TheoFizzarotti/Gardien-de-babyfoot-automatique/Rapports séance/Théo FIZZAROTTI/Projet Séance 3.pdf

Début du programme du moteur. Comme c’est un moteur pas à pas, lorsque nous voulons qu’il fasse une rotation, nous devons calculer le nombre de pas qu’il doit faire pour que la rotation soit effectuée. Le pas est de 1,8°. Le diamètre du pignon est de 4,5 cm. Donc la course de la crémaillère pour un tour complet de pignon est de 0,045π m/tour.
Soit pour un pas, 0,225π mm/pas soit environ 0,707 mm/pas. Maintenant j’ai besoin de savoir dans chaque tour de boucle du programme, la distance que je dois faire, pour cela je dois réceptionner cette information de la pixycam et c’est Théo qui s’en charge, je dois donc avoir cette information pour continuer.

Programme actuel :

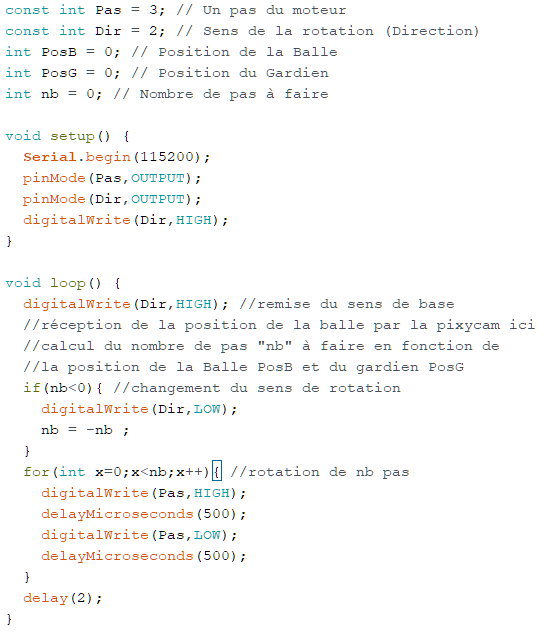
[picture p9: figure]

Pour recevoir cette information, nous devons utiliser des modules Bluetooth, j’ai donc de mon côté fais le branchement du module esclave :

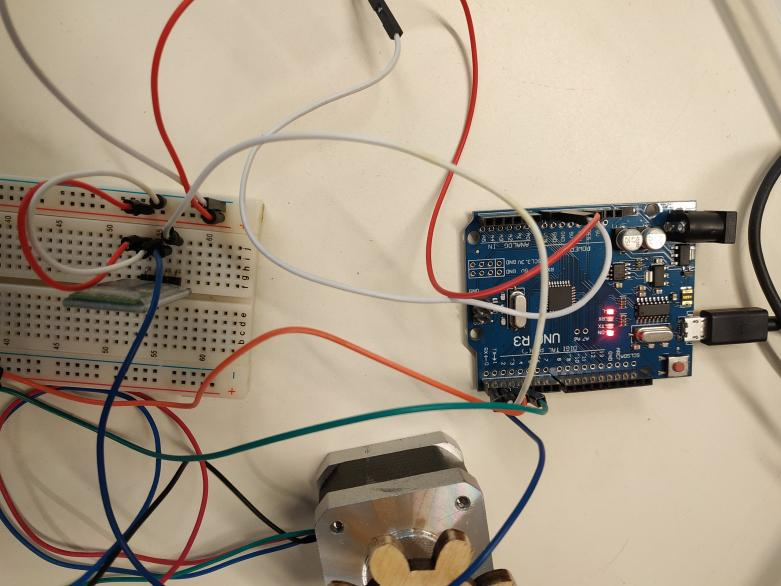
[picture p10: figure]

Théo a lui, de son côté, fait le branchement du module maître, nous avons ensuite récupéré les programmes Arduino du cours sur le Bluetooth de M.Masson, mais nous n’avons pas réussi pour le moment à établir la communication entre les 2 modules Bluetooth.
Objectif de la prochaine séance : Réussir à établir la communication entre les 2 modules Bluetooth afin de réceptionner l’information de position de la balle de la pixycam.
