TheoFizzarotti/Gardien-de-babyfoot-automatique/Rapports séance/NOCENTINI Théo/Rapport 3.pdf

Séance 3

Maintenant que la coordonnée de la balle est récupéré par la Pixycam,, et stockée dans une variable du code de l’arduino. Il faut envoyer cette variable à une seconde Arduino.
Pour cela je me suis renseigné sur des modules bluetooth et j*********** **** l’exemple de la vidéo suivante: https://www.youtube.com/watch?v=hyME1osgr7s
pour vérifier le fonctionnement du bluetooth.
J’ai donc fait le branchement “Maitre”

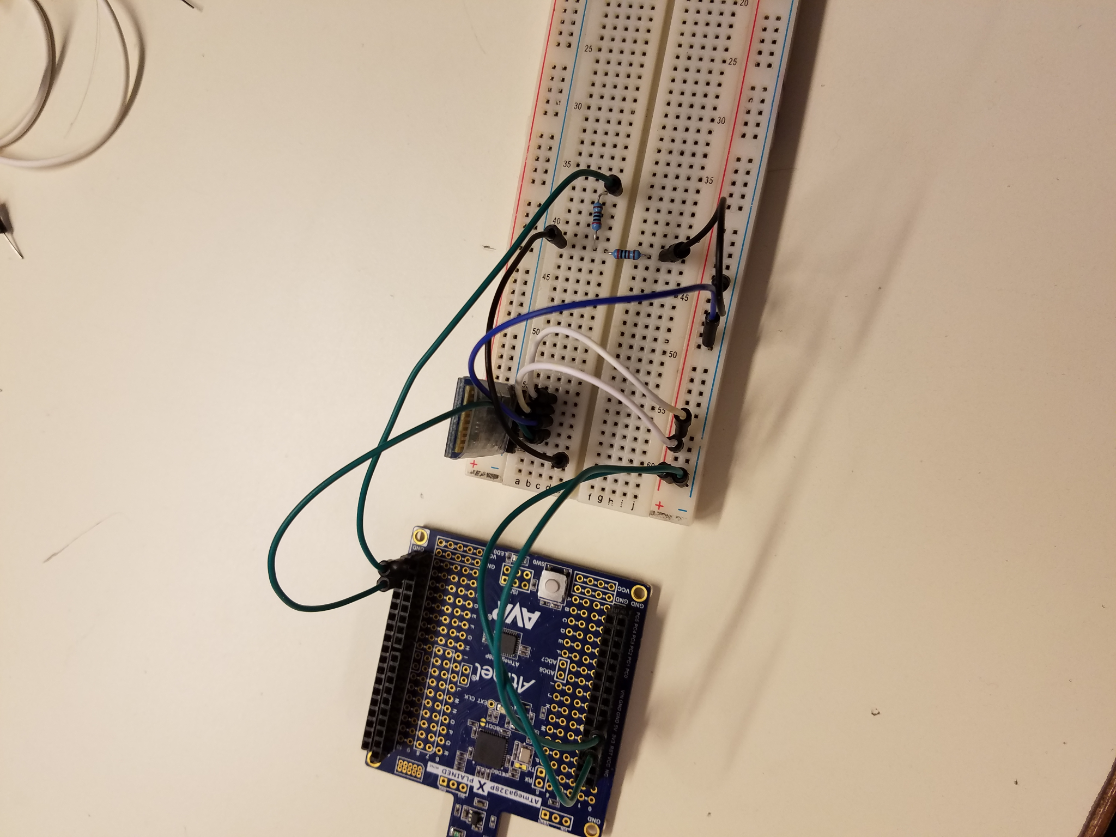
[picture p11: figure]

Ensuite, il fallait donc que j’utilise l’autre carte Arduino pour faire le montage “esclave”, et que l’on réfléchisse pour transformer la coordonnée en mouvement sur le moteur, il a donc fallu mettre nos travaux en commun.

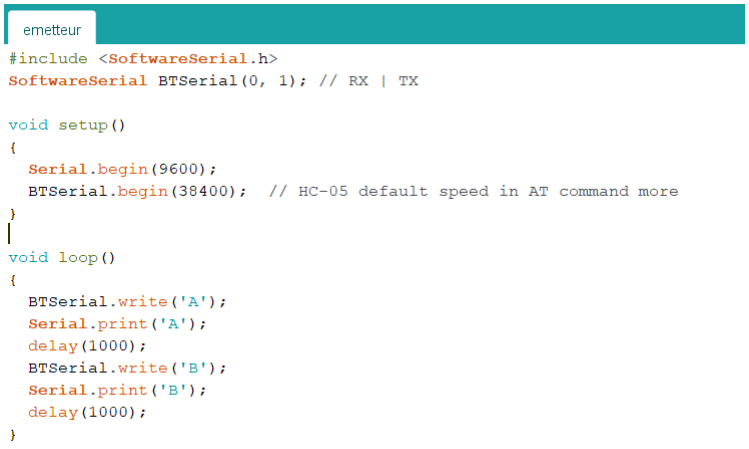
[picture p12: figure]

Voila donc le code “Maitre”, une fois qu’on aura verifié qu’il est fonctionnel il suffira de write les coordonnées que nous avons récupéré dans la séance précédente.

Le code “slave” va recevoir cette valeur et va la transformer en nombre de pas du moteur.

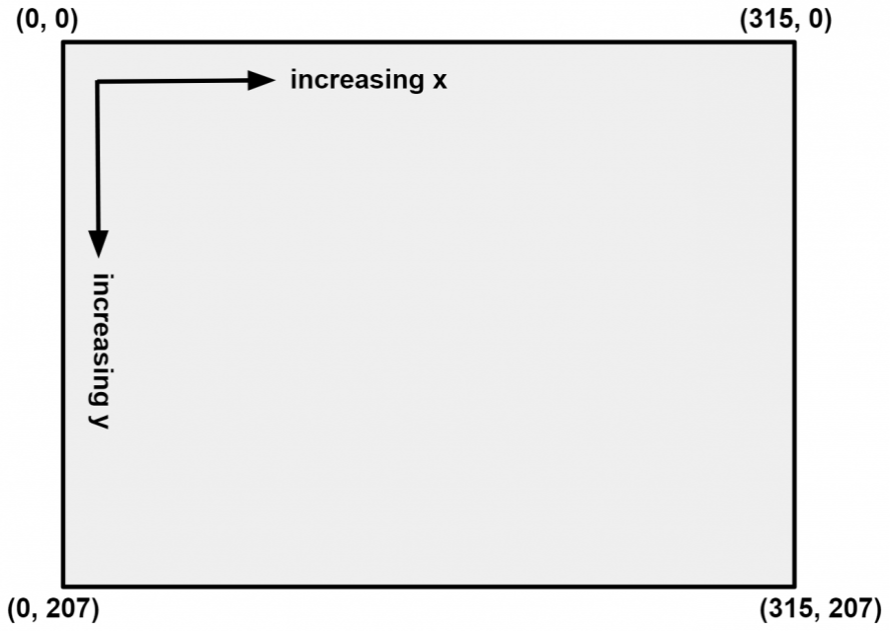
[picture p13: figure]

Voici la vision de la Pixycam, selon la ou on la place nous devrons simplement regarder la coordonnée x ou y.

Il faudra placer la caméra en hauteur tel que la caméra voit environ 72cm en largeur.
Ensuite nous pourrons calculer la distance a laquelle corresponds 1 unité de x. Puis on pourra transformer cette valeur en nombre de pas sur le moteur.
