TheoFizzarotti/Gardien-de-babyfoot-automatique/Rapports séance/Théo FIZZAROTTI/Projet Séance 7.pdf

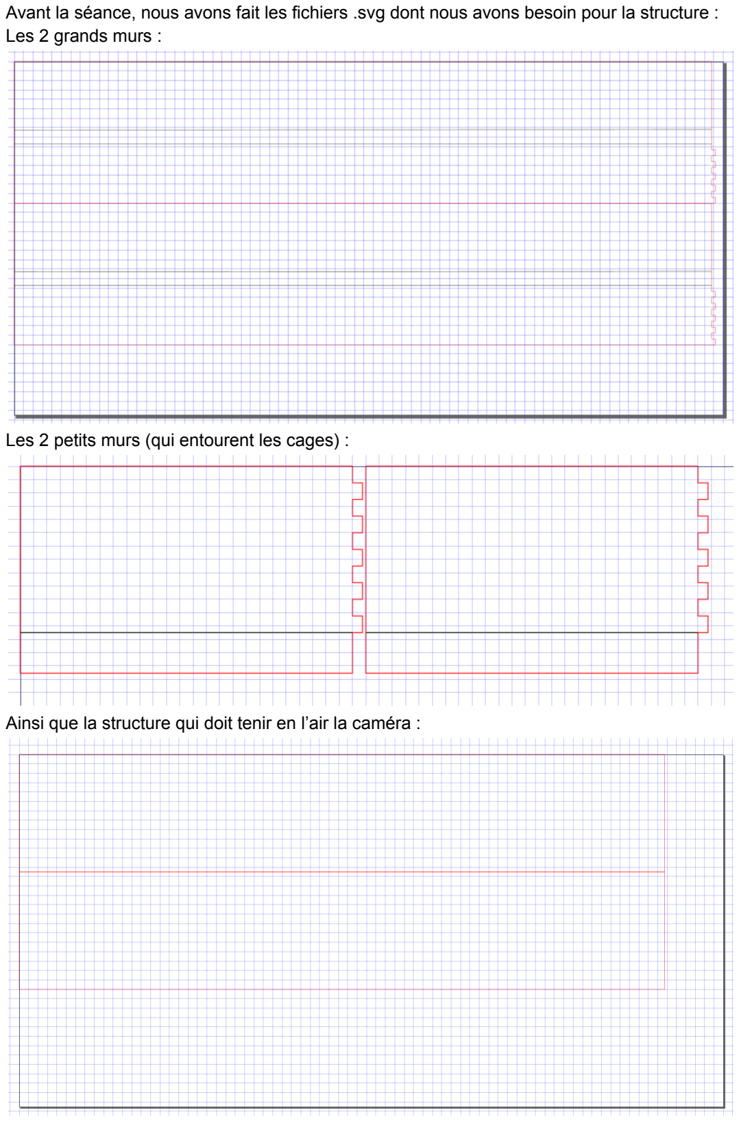
[picture p25: page 1]

Avant la séance, nous avons fait les fichiers .svg dont nous avons besoin pour la structure : Les 2 grands murs :

Les 2 petits murs (qui entourent les cages) :

Ainsi que la structure qui doit tenir en l’air la caméra :

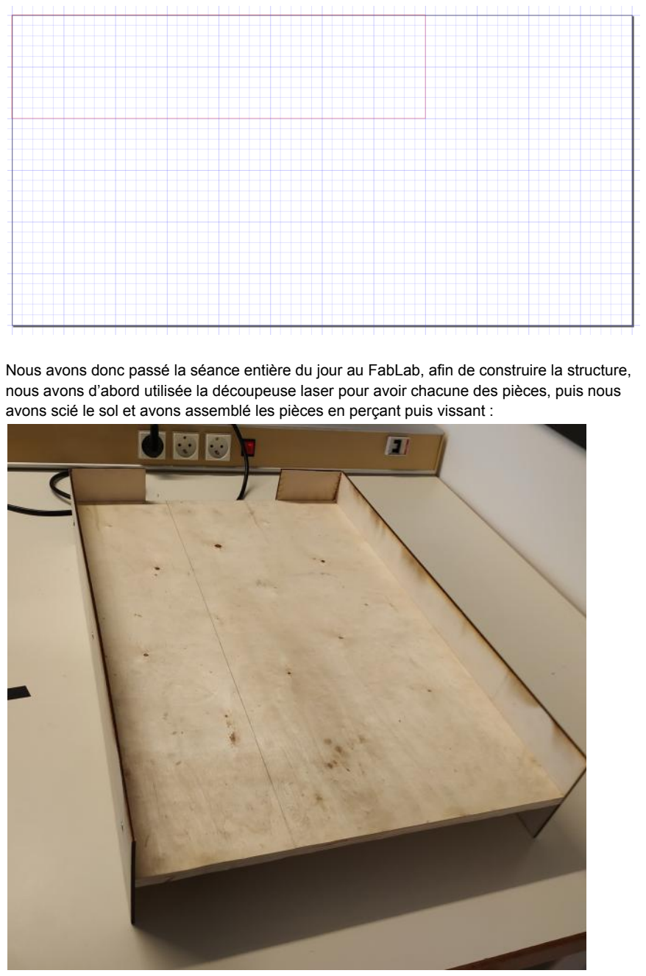
[picture p26: page 2]

Nous avons donc passé la séance entière du jour au FabLab, afin de construire la structure, nous avons d’abord utilisée la découpeuse laser pour avoir chacune des pièces, puis nous avons scié le sol et avons assemblé les pièces en perçant puis vissant :

Comme nous avons encore pas mal de travail sur la structure et que nous devons ensuite tester nos programmes sur celle-ci, nous avons l’objectif de passer au FabLab dans la semaine (avant la séance prochaine) afin de continuer l’avancement de la structure et de pouvoir lors de la prochaine tout brancher et tester l’ensemble programmes / mécanismes / structures.
