TheoFizzarotti/Gardien-de-babyfoot-automatique/Rapports séance/NOCENTINI Théo/Rapport séance 7.pdf

Nous avons passé l'entièreté de la séance à construire la structure du babyfoot, les découpes lasers avaient été préparées en avance, nous avons donc pu découper le bois et visser ensemble le sol et les murs.

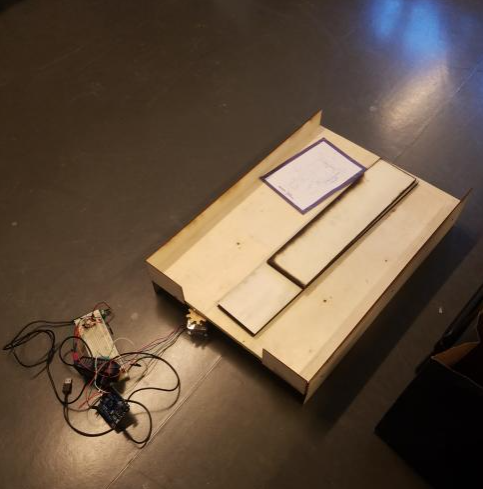
[picture p27: figure]

Le projet prend forme, il ne reste plus qu’à monter la caméra au-dessus du terrain mais ce n’est pas réalisable aujourd’hui car le fablab n’est plus accessible et que notre planche qui soutient la caméra est légèrement trop longue.

Il nous reste également à faire un trou dans cette dernière planche ainsi que de faire un support pour la crémaillère, ainsi que de quoi bloquer la rotation pour ne garder que la translation de la crémaillère.

D’ici la prochaine séance nous aimerions avoir fini la structure pour pouvoir commencer les tests.
