TheoFizzarotti/Gardien-de-babyfoot-automatique/Rapports séance/Théo FIZZAROTTI/Projet Séance 4.pdf

Tentative de communication entre les 2 modules Bluetooth, entre le Maître et l’Esclave, je possède le module Esclave, j’ai donc utilisé ce programme :

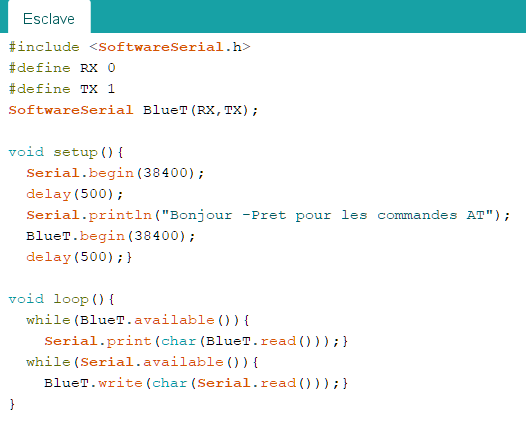
[picture p28: figure]

Puis nous avons fait l’Oral de présentation du Projet et de notre avancée.

En attendant de l’aide pour la communication Bluetooth, j’ai travaillé sur le programme du moteur puis sur les plans avec le positionnement de la caméra.

Le moteur refusait de fonctionner selon le programme, j’ai donc dû faire quelques tests afin de trouver d’où venait le problème, il venait en fait du délai qui était trop court entre les pas, j’ai donc dû augmenter celui-ci et voici donc l’état du programme actuel :

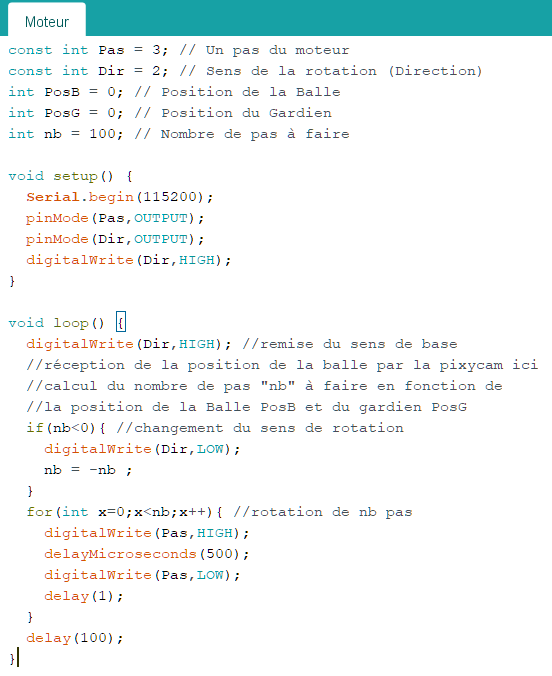
[picture p29: figure]

Voici les plans papiers du babyfoot et du positionnement de la caméra, ils seront à reproduire sur ordinateur dans une version pour la découpeuse de bois :

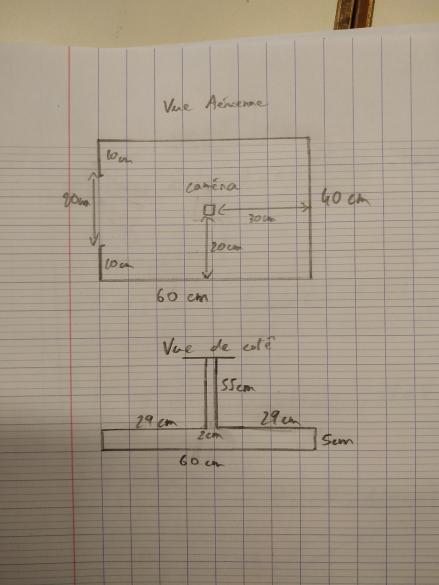
[picture p30: figure]

Objectif de la prochaine séance : Demander à M.Masson de nous aider à faire communiquer les modules Bluetooth entre eux puis travailler sur le programme du moteur en fonction des coordonnées reçues.
