TheoFizzarotti/Gardien-de-babyfoot-automatique/Rapports séance/Joueur_-_Body_P2.stl

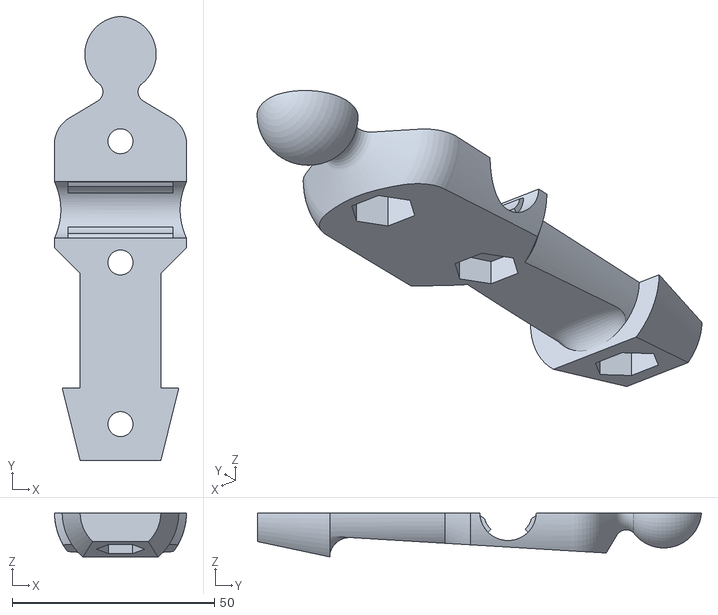
[picture p31: CAD file, 2021-12-02, last stored version]
Rapports séance/Joueur_-_Body_P2.stl
32.7 x 109.9 x 10.9
