TheoFizzarotti/Gardien-de-babyfoot-automatique/Soutenance de Projet -NOCENTINI FIZZAROTTI.pdf

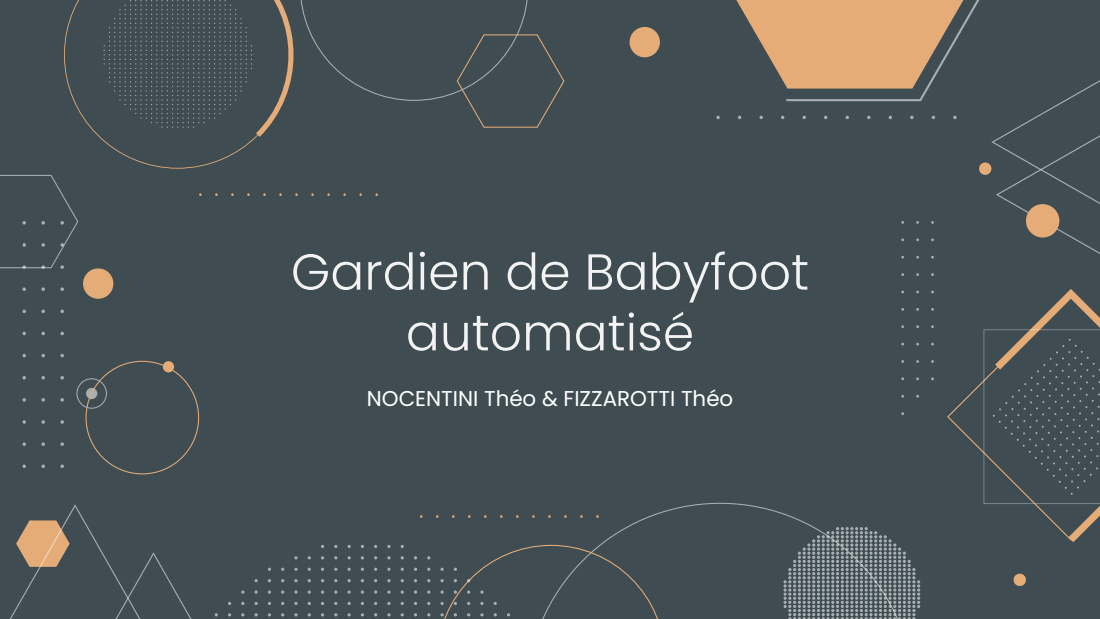
[picture p32: page 1]

Gardien de Babyfoot
automatisé

NOCENTINI Théo & FIZZAROTTI Théo

### 01. Objectifs du projet

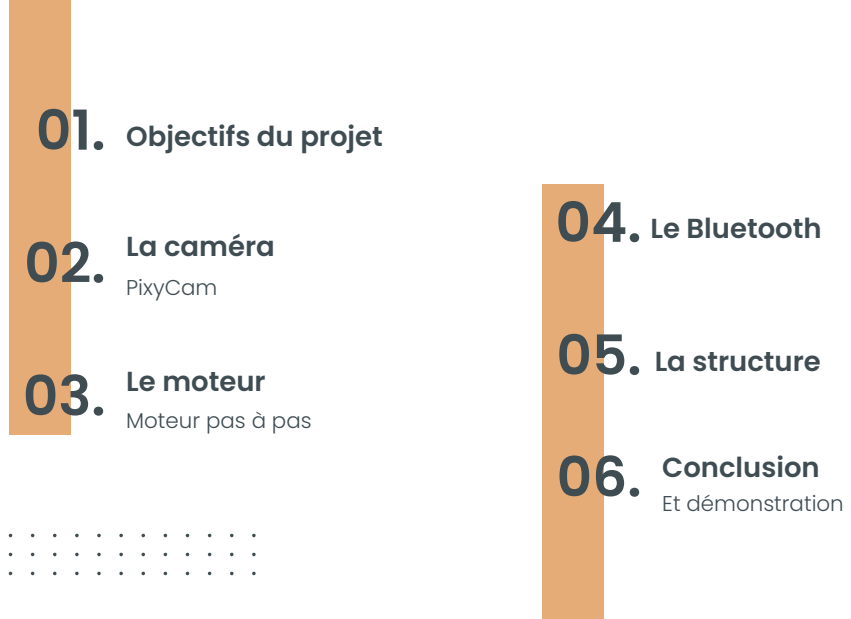
[picture p33: page 2]
02. La caméra; 05. La structure; Conclusion; PixyCam; 06. Et démonstration; Le Bluetooth

03. Moteur pas à pas
Le moteur

01

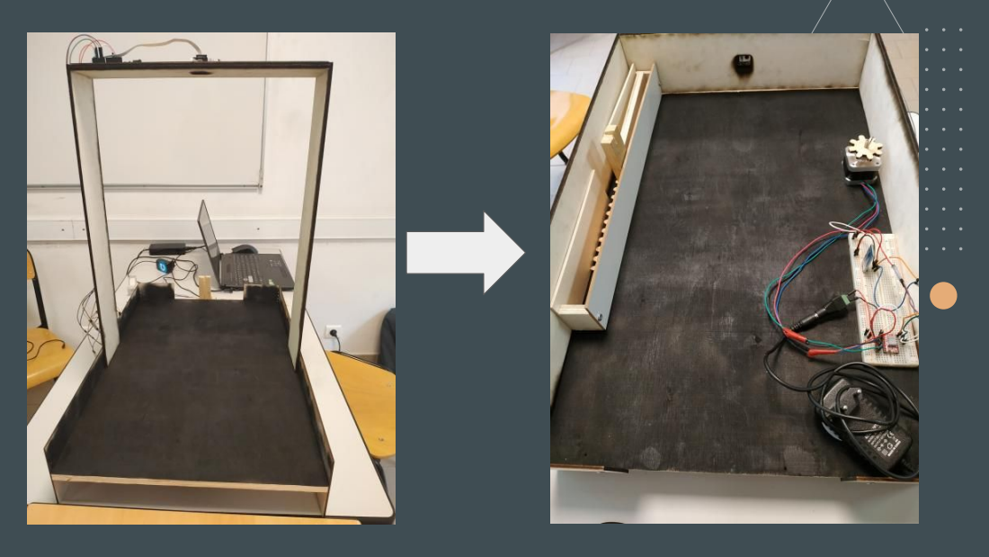
[picture p34: page 3]
Objectifs du projet

02

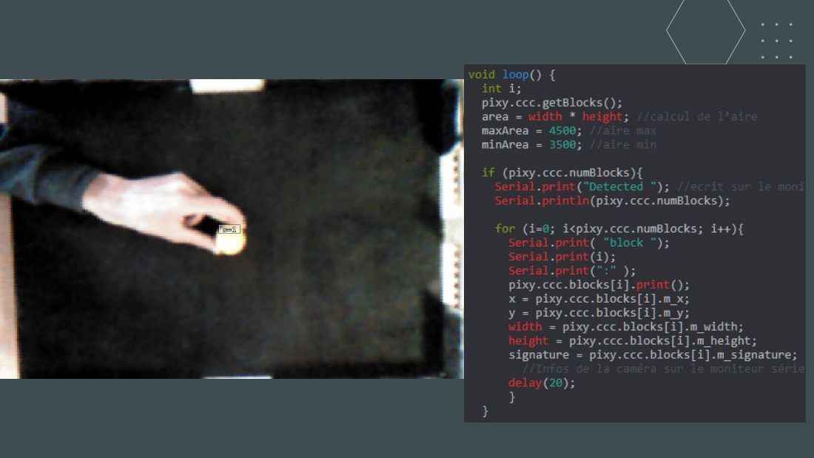
[picture p35: page 4]
La Caméra

03

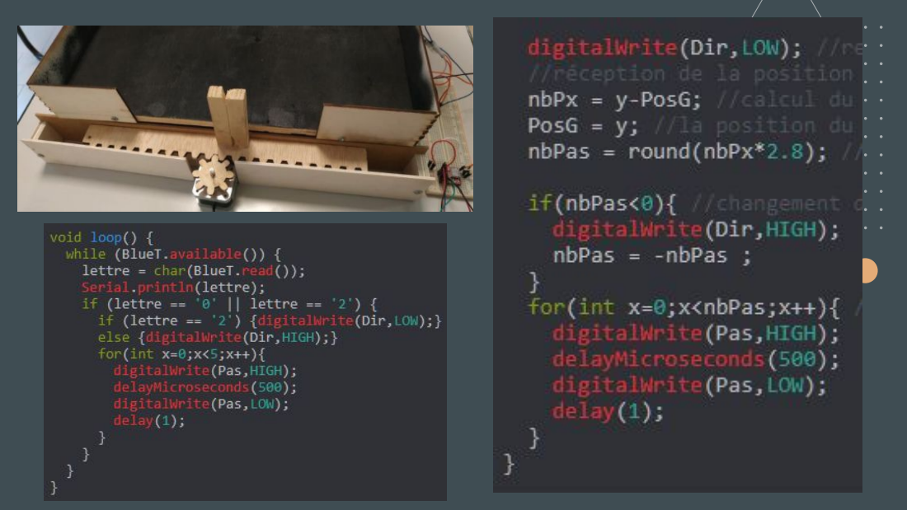
[picture p36: page 5]
Le moteur

04

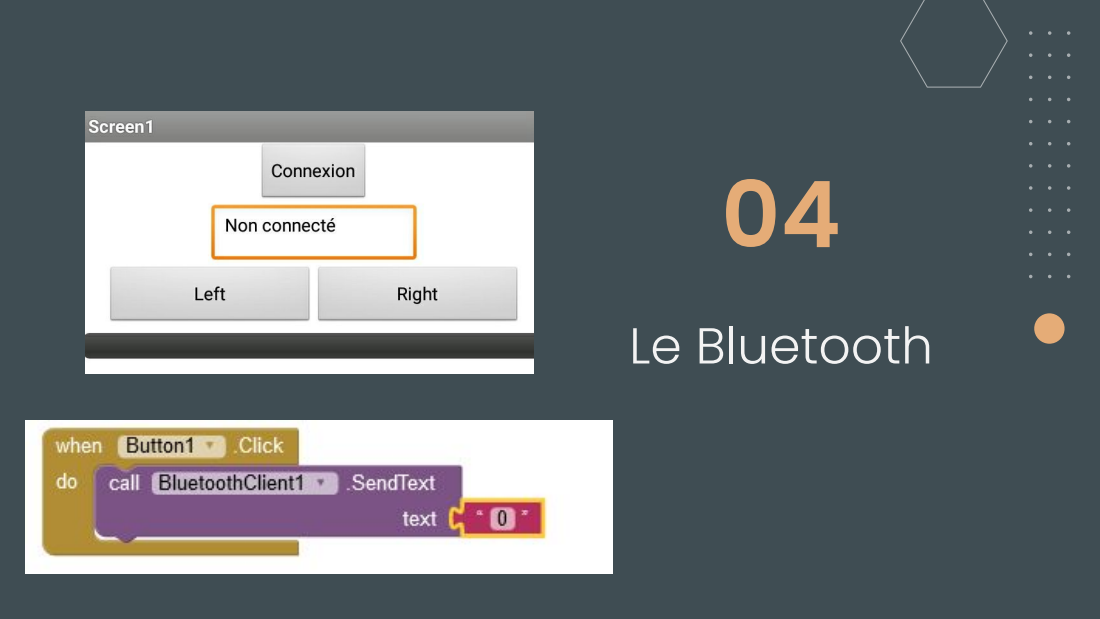
[picture p37: page 6]
Le Bluetooth

05

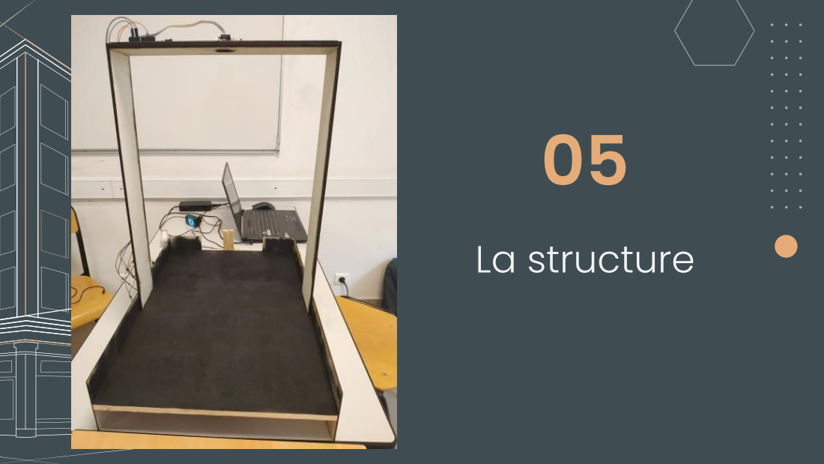
[picture p38: page 7]
La structure

06

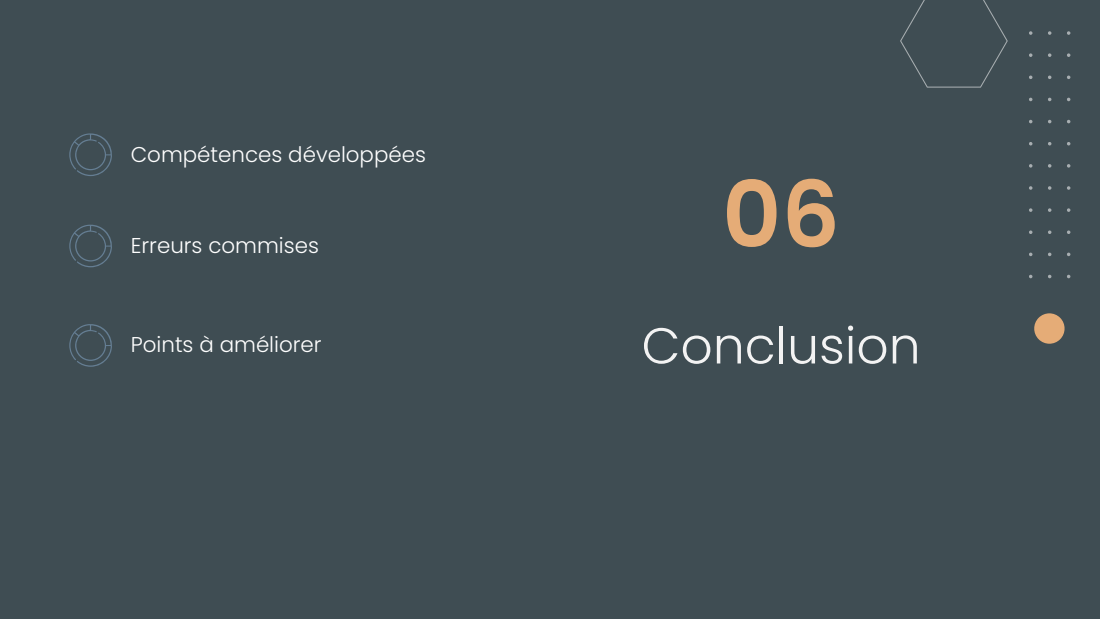
[picture p39: page 8]
Conclusion; Compétences développées; Erreurs commises; Points à améliorer
